CREATE-ROCKET/Avi_Ethernet_Test_Board/kicad/ethernet_test_board/footprints/LM66100DCKR/LM66100DCKR.step

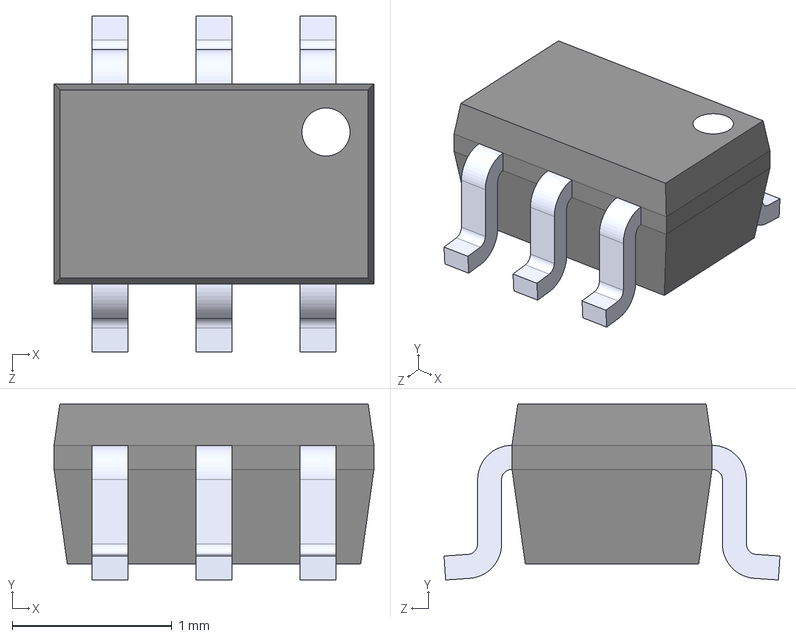
[picture p1: CAD file, 2025-05-19]
kicad/ethernet_test_board/footprints/LM66100DCKR/LM66100DCKR.step
2.00 x 1.10 x 2.10 mm
