CREATE-ROCKET/Avi_Ethernet_Test_Board/kicad/ethernet_test_board/ethernet_test_board.kicad_pcb

## KiCad design kicad/ethernet_test_board/ethernet_test_board.kicad_pcb (2025-08-08)

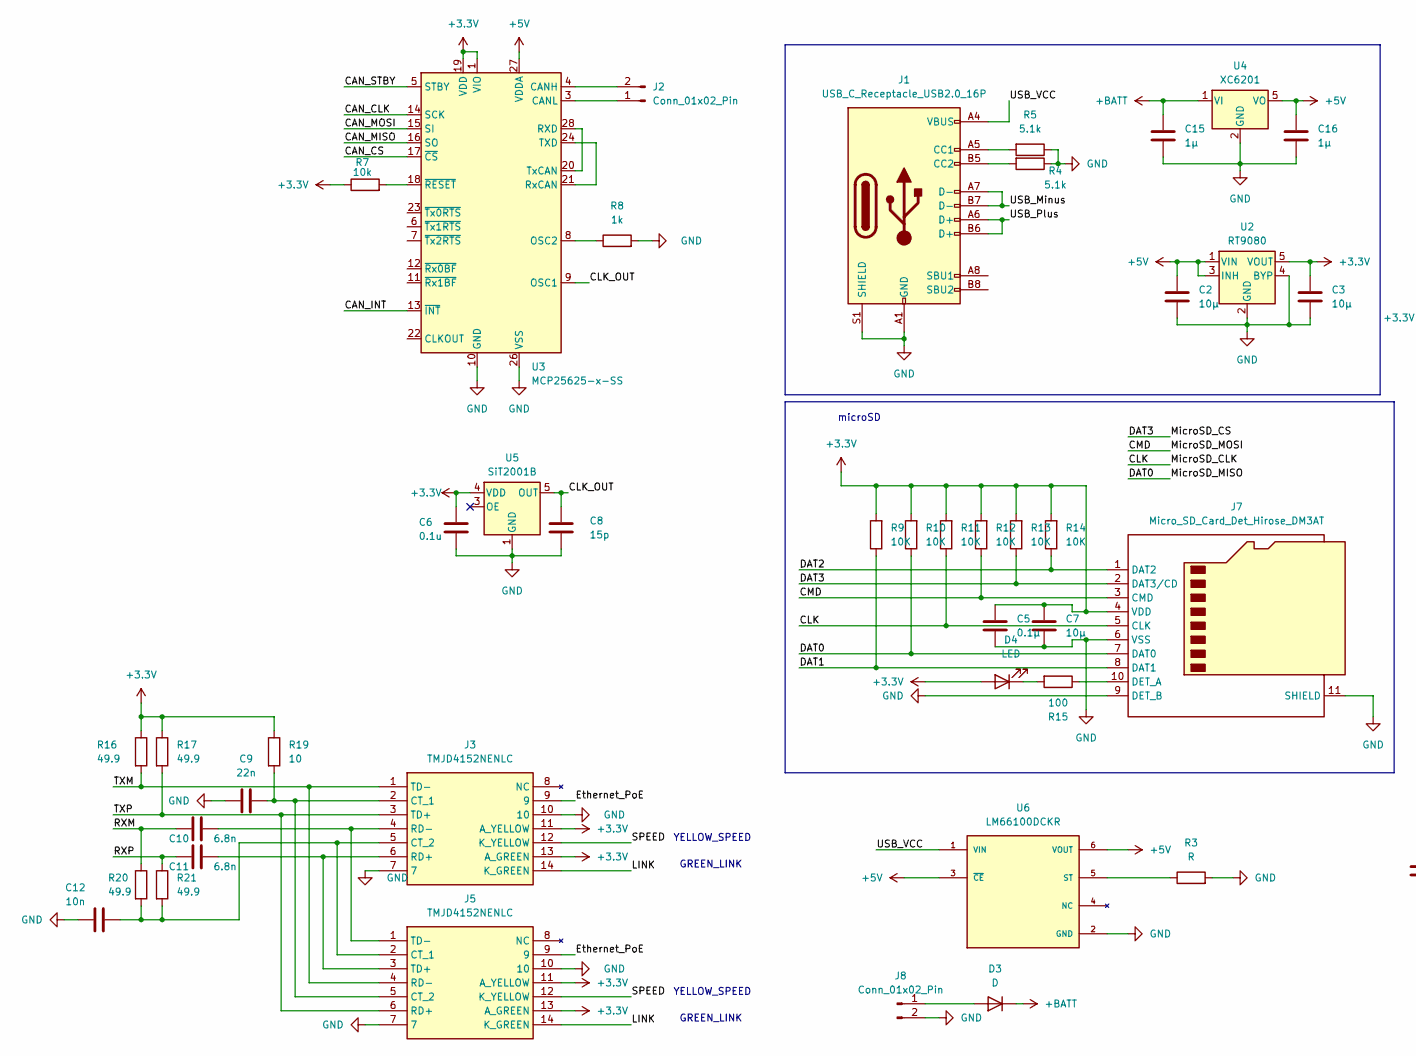
[picture p2: schematic ethernet_test_board.kicad_sch, part in row 1, column 1]

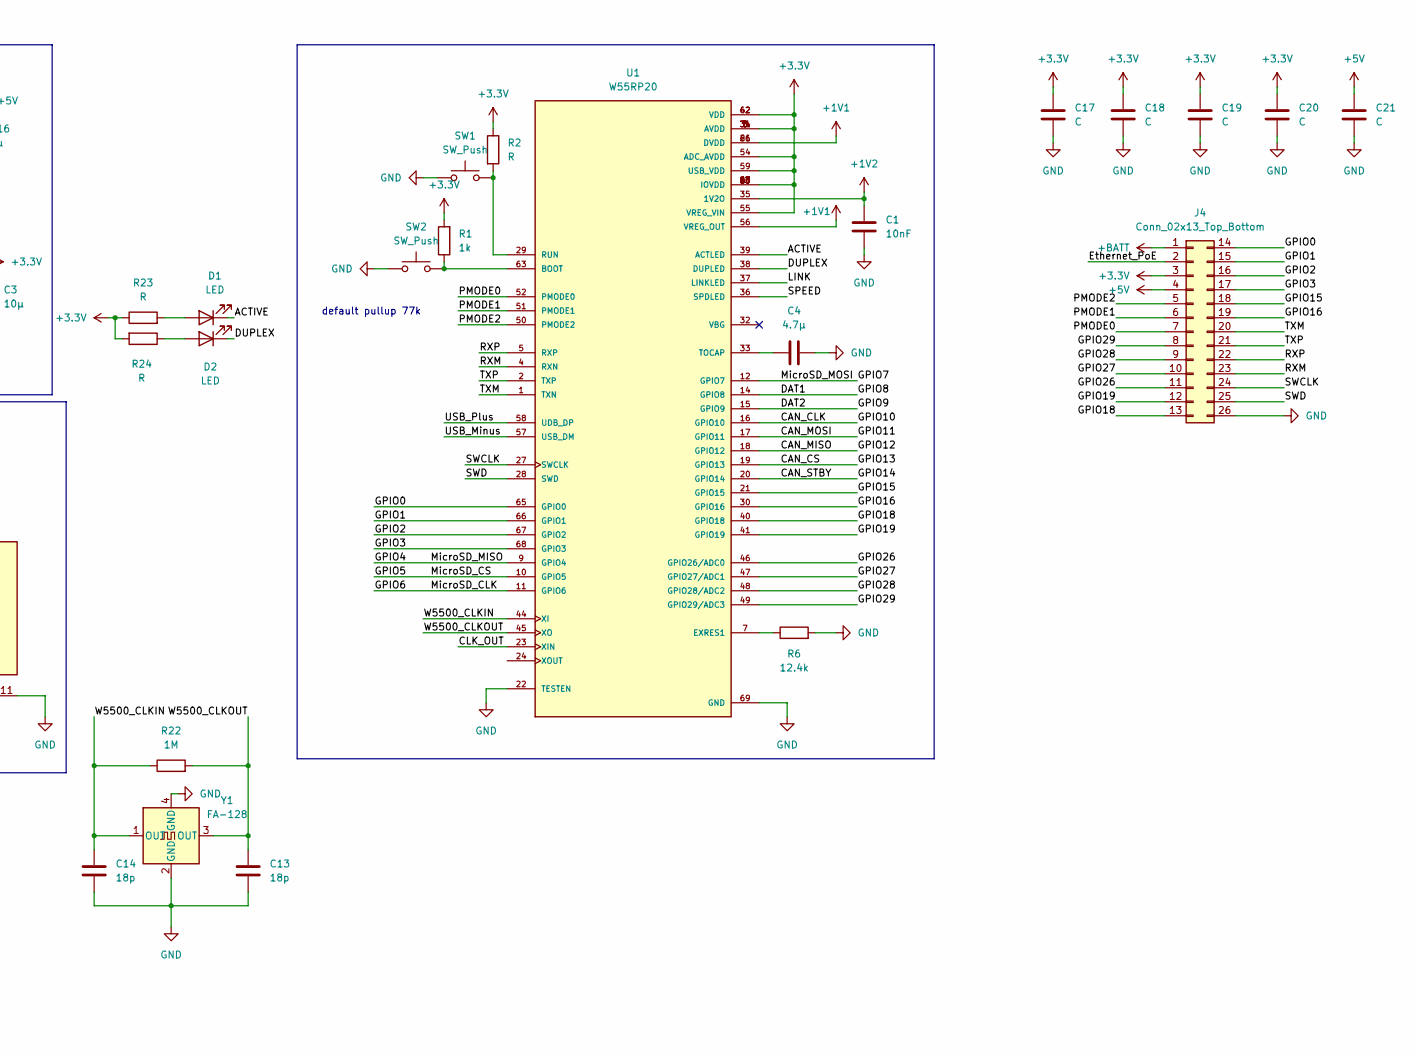
[picture p3: schematic ethernet_test_board.kicad_sch, part in row 1, column 2]

Parts:
C1: 10nF; C_0603_1608Metric
C2, C3, C7: 10μ; C_0603_1608Metric
C4: 4.7μ; C_0603_1608Metric
C5: 0.1μ; C_0603_1608Metric
C6: 0.1u; C_0603_1608Metric
C8: 15p; C_0603_1608Metric
C9: 22n; C_0603_1608Metric
C10, C11: 6.8n; C_0603_1608Metric
C12: 10n; C_0603_1608Metric
C13, C14: 18p; C_0603_1608Metric
C15, C16: 1μ; C_0603_1608Metric
C17, C18, C19, C20, C21: C; C_0603_1608Metric_Pad1.08x0.95mm_HandSolder
D1, D2: LED; C_0603_1608Metric
D3: D; C_0603_1608Metric_Pad1.08x0.95mm_HandSolder
D4: LED; LED_0603_1608Metric
J1: USB_C_Receptacle_USB2.0_16P; USB_C_Receptacle_GCT_USB4105-xx-A_16P_TopMnt_Horizontal
J2: Conn_01x02_Pin; ILG2pin
J3, J5: TMJD4152NENLC; Manufacturer_Part_Number TMJD4152NENLC; Mouser Part Number 960-TMJD4152NENLC
J4: Conn_02x13_Top_Bottom; PinHeader_2x13_P2.54mm_Vertical
J7: Micro_SD_Card_Det_Hirose_DM3AT; microSD_HC_Hirose_DM3AT-SF-PEJM5
J8: Conn_01x02_Pin; JST_VH_B2P-VH-B_1x02_P3.96mm_Vertical
R1: 1k; C_0603_1608Metric
R2, R3, R23, R24: R; C_0603_1608Metric
R4, R5: 5.1k; C_0603_1608Metric
R6: 12.4k; C_0603_1608Metric
R7: 10k; R_0603_1608Metric
R8: 1k; R_0603_1608Metric
R9, R10, R11, R12, R13, R14: 10K; R_0603_1608Metric
R15: 100; R_0603_1608Metric
R16, R17, R20, R21: 49.9; C_0603_1608Metric
R19: 10; C_0603_1608Metric
R22: 1M; C_0603_1608Metric
SW1, SW2: SW_Push; SW_PUSH_6mm_H7.3mm
U1: W55RP20; QFN40P800X800X90-69N; PARTREV 0.1.0
U2: RT9080; TSOT-23-5
U3: MCP25625-x-SS; SSOP-28_5.3x10.2mm_P0.65mm
U4: XC6201; SOT-23-5
U5: SiT2001B; SOT-23-5
U6: LM66100DCKR; SOT65P210X110-6N; PARTREV Rev. A
Y1: FA-128; Oscillator_SMD_SeikoEpson_SG210-4Pin_2.5x2.0mm

Connections:
+1V1: U1.26 (DVDD), U1.56 (VREG_OUT), U1.61 (DVDD)
+1V2: C1.2, U1.35 (1V2O)
+3.3V: C3.1, C5.1, C6.1, C7.1, C17.1, C18.1, C19.1, C20.1, D4.2 (A), J3.11 (A_YELLOW), J3.13 (A_GREEN), J4.3, J5.11 (A_YELLOW), J5.13 (A_GREEN), J7.4 (VDD), R1.2, R2.1, R7.1, R9.2, R10.2, R11.2, R12.2, R13.2, R14.2, R16.1, R17.1, R19.1, R23.1, R24.2, U1.3 (AVDD), U1.6 (AVDD), U1.8 (AVDD), U1.13 (IOVDD), U1.25 (IOVDD), U1.31 (AVDD), U1.34 (AVDD), U1.42 (VDD), U1.43 (IOVDD), U1.53 (IOVDD), U1.54 (ADC_AVDD), U1.55 (VREG_VIN), U1.59 (USB_VDD), U1.60 (IOVDD), U1.62 (VDD), U1.64 (IOVDD), U2.5 (VOUT), U3.1 (VIO), U3.19 (VDD), U5.4 (VDD)
+5V: C2.1, C16.1, C21.1, J4.4, U2.1 (VIN), U2.3 (INH), U3.27 (VDDA), U4.5 (VO), U6.3 (~CE), U6.6 (VOUT)
+BATT: C15.1, D3.1 (K), J4.1, U4.1 (VI)
/ACTIVE: D1.1 (K), U1.39 (ACTLED)
/CAN_CLK: U1.16 (GPIO10), U3.14 (SCK)
/CAN_CS: U1.19 (GPIO13), U3.17 (~CS)
/CAN_INT: U3.13 (~INT)
/CAN_MISO: U1.18 (GPIO12), U3.16 (SO)
/CAN_MOSI: U1.17 (GPIO11), U3.15 (SI)
/CAN_STBY: U1.20 (GPIO14), U3.5 (STBY)
/CLK: J7.5 (CLK), R11.1, U1.11 (GPIO6)
/CLK_OUT: C8.1, U1.23 (XIN), U3.9 (OSC1), U5.5 (OUT)
/CMD: J7.3 (CMD), R12.1, U1.12 (GPIO7)
/DAT0: J7.7 (DAT0), R10.1, U1.9 (GPIO4)
/DAT1: J7.8 (DAT1), R9.1, U1.14 (GPIO8)
/DAT2: J7.1 (DAT2), R14.1, U1.15 (GPIO9)
/DAT3: J7.2 (DAT3/CD), R13.1, U1.10 (GPIO5)
/DUPLEX: D2.1 (K), U1.38 (DUPLED)
/Ethernet_PoE: J3.9, J4.2, J5.9
/GPIO0: J4.14, U1.65 (GPIO0)
/GPIO1: J4.15, U1.66 (GPIO1)
/GPIO2: J4.16, U1.67 (GPIO2)
/GPIO3: J4.17, U1.68 (GPIO3)
/GPIO15: J4.18, U1.21 (GPIO15)
/GPIO16: J4.19, U1.30 (GPIO16)
/GPIO18: J4.13, U1.40 (GPIO18)
/GPIO19: J4.12, U1.41 (GPIO19)
/GPIO26: J4.11, U1.46 (GPIO26/ADC0)
/GPIO27: J4.10, U1.47 (GPIO27/ADC1)
/GPIO28: J4.9, U1.48 (GPIO28/ADC2)
/GPIO29: J4.8, U1.49 (GPIO29/ADC3)
/LINK: J3.14 (K_GREEN), J5.14 (K_GREEN), U1.37 (LINKLED)
/PMODE0: J4.7, U1.52 (PMODE0)
/PMODE1: J4.6, U1.51 (PMODE1)
/PMODE2: J4.5, U1.50 (PMODE2)
/RXM: C10.1, J4.23, R20.1, U1.4 (RXN)
/RXP: C11.1, J4.22, R21.1, U1.5 (RXP)
/SPEED: J3.12 (K_YELLOW), J5.12 (K_YELLOW), U1.36 (SPDLED)
/SWCLK: J4.24, U1.27 (SWCLK)
/SWD: J4.25, U1.28 (SWD)
/TXM: J3.1 (TD-), J4.20, J5.4 (RD-), R16.2, U1.1 (TXN)
/TXP: J3.3 (TD+), J4.21, J5.6 (RD+), R17.2, U1.2 (TXP)
/USB_Minus: J1.A7 (D-), J1.B7 (D-), U1.57 (USB_DM)
/USB_Plus: J1.A6 (D+), J1.B6 (D+), U1.58 (UDB_DP)
/USB_VCC: J1.A4 (VBUS), J1.A9 (VBUS), J1.B4 (VBUS), J1.B9 (VBUS), U6.1 (VIN)
/W5500_CLKIN: C14.1, R22.1, U1.44 (XI), Y1.1 (OUT)
/W5500_CLKOUT: C13.1, R22.2, U1.45 (XO), Y1.3 (OUT)
GND: C1.1, C2.2, C3.2, C4.1, C5.2, C6.2, C7.2, C8.2, C9.1, C12.2, C13.2, C14.2, C15.2, C16.2, C17.2, C18.2, C19.2, C20.2, C21.2, J1.A1 (GND), J1.A12 (GND), J1.B1 (GND), J1.B12 (GND), J1.S1 (SHIELD), J3.7, J3.10, J4.26, J5.7, J5.10, J7.6 (VSS), J7.9 (DET_B), J7.11 (SHIELD), J8.2, R3.2, R4.1, R5.1, R6.2, R8.2, SW1.1, SW2.1, U1.22 (TESTEN), U1.69 (GND), U2.2 (GND), U2.4 (BYP), U3.10 (GND), U3.26 (VSS), U4.2 (GND), U5.1 (GND), U6.2 (GND), Y1.2 (GND), Y1.4 (GND)
unnamed: D1.2 (A), R23.2
unnamed: D2.2 (A), R24.1
unnamed: D3.2 (A), J8.1
unnamed: D4.1 (K), R15.2
unnamed: J1.A5 (CC1), R5.2
unnamed: J1.B5 (CC2), R4.2
unnamed: J2.1, U3.3 (CANL)
unnamed: J2.2, U3.4 (CANH)
unnamed: C9.2, J3.2 (CT_1), J5.5 (CT_2), R19.2
unnamed: C12.1, J3.5 (CT_2), J5.2 (CT_1), R20.2, R21.2
unnamed: C11.2, J3.6 (RD+), J5.3 (TD+)
unnamed: C10.2, J3.4 (RD-), J5.1 (TD-)
unnamed: J7.10 (DET_A), R15.1
unnamed: R1.1, SW2.2, U1.63 (BOOT)
unnamed: R6.1, U1.7 (EXRES1)
unnamed: R2.2, SW1.2, U1.29 (RUN)
unnamed: C4.2, U1.33 (TOCAP)
unnamed: R8.1, U3.8 (OSC2)
unnamed: U3.20 (TxCAN), U3.28 (RXD)
unnamed: U3.21 (RxCAN), U3.24 (TXD)
unnamed: R7.2, U3.18 (~RESET)
unnamed: R3.1, U6.5 (ST)

Notes on the sheet:
microSD
GREEN_LINK
YELLOW_SPEED
default pullup 77k

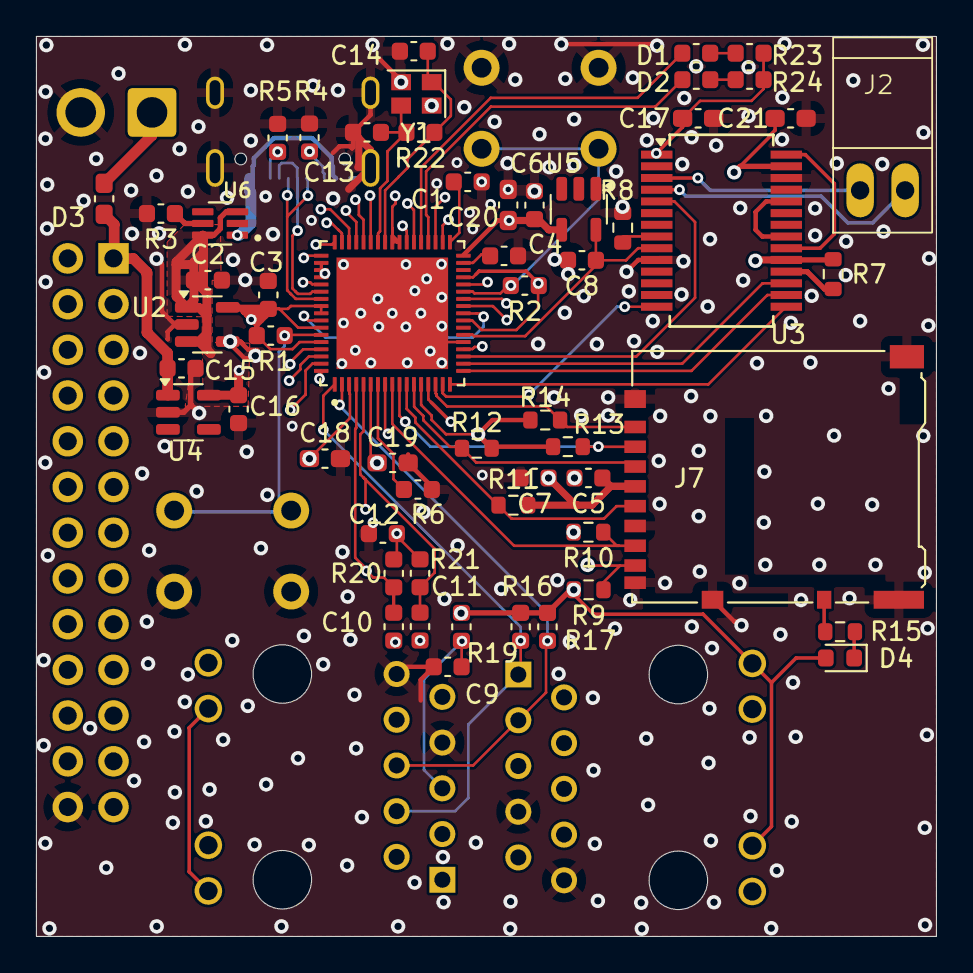
[picture p4: board ethernet_test_board.kicad_pcb from above]

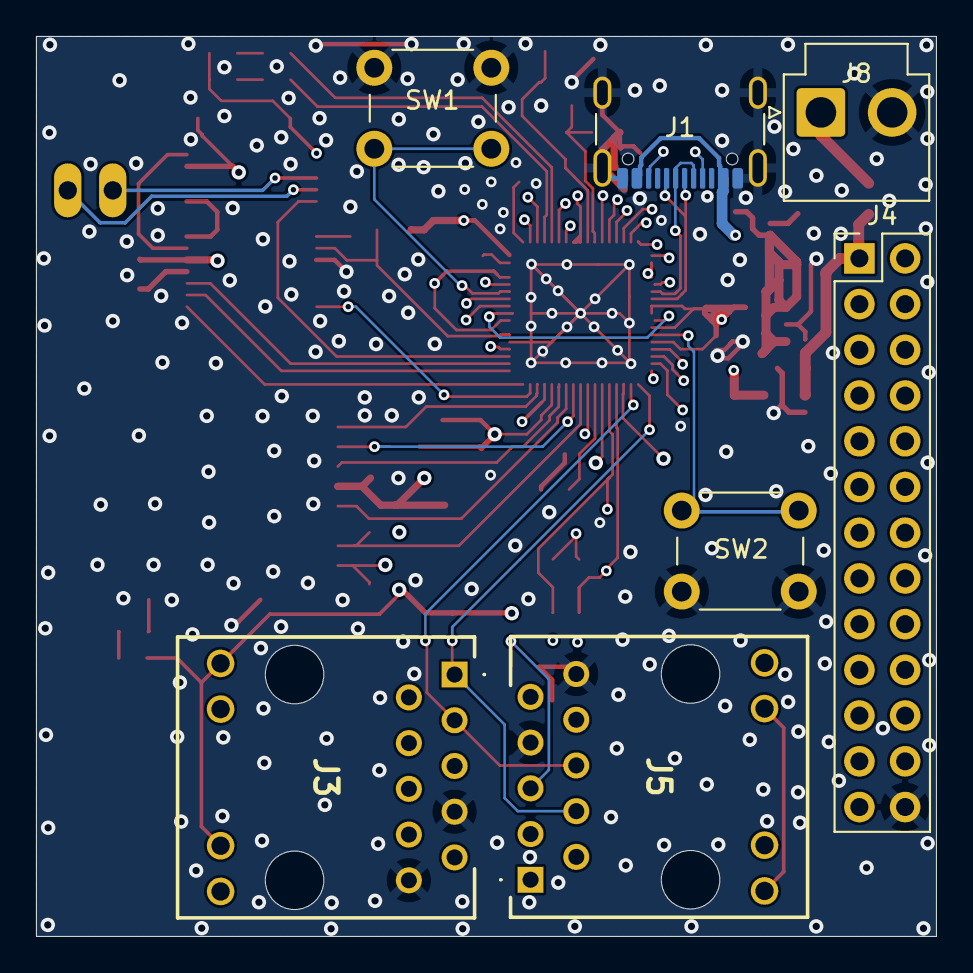
[picture p5: board ethernet_test_board.kicad_pcb from below]

Board: 8 copper layers, 50.0 x 50.0 mm, 64 parts (7 on the bottom side), 71 nets.
