CREATE-ROCKET/Avi_Ethernet_Test_Board/(commit log)

2025-05-02 init commit (kicad WIP)
    [ethernet_test_board.kicad_pcb, ethernet_test_board.kicad_sch]
2025-05-19 [add] kicad sch (finish) kicad pcb (WIP)
    [LM66100DCKR.step, ethernet_test_board.kicad_pcb, ethernet_test_board.kicad_sch]
2025-06-12 [fix] kicad ethernet error
    [bom.csv, designators.csv, ethernet_test_board.kicad_pcb, ethernet_test_board.kicad_sch, positions.csv]
2025-07-07 [add] kicad pcb
    [ethernet_test_board.kicad_pcb, ethernet_test_board.kicad_sch]
2025-08-05 [fix] fix pcb error
    [ethernet_test_board.kicad_pcb, positions.csv]
2025-08-08 [fix] via size
    [ethernet_test_board.kicad_pcb]
